sebas-mora28/Formula-E-CE-TEC-I/README.md

# PROYECTO-II

## Información 

Tecnólogico de Costa Rica 

Taller de Programación, I semestre 2019

**Estudiantes:** 

Sebastian Mora Godínez.

Santiago Brenes Torres.

**Profesor:**

Pedro Gutiérrez García.

### Versión de Python

Python v.3.7.2 es la utilizada en la elaboración de este proyecto.

## Archivos del proyecto 
 
 Encuentre en el siguiente link todos los archivos necesarios del proyecto
 
 [Descargue aquí los archivos del proyecto](https://github.com/sebas-mora28/PROYECTO-II/archive/master.zip)

## Documentación del proyecto

Encuentre en el siguiente link toda la documentación relacionada con el proyecto

[Documentacion del proyecto](https://1drv.ms/f/s!AhSq2J7a9CFx9wp0yKUWT9QH4UC5)

## Consideración

Asegúrese cambiar la red Wi-Fi tanto en el código de arduino como en el Wi-Fi client. 

Asegúrese utilizar una bateria de 9V totalmente cargada para garantizar el correcto funcionamiento.
